dienvx1997bn/doan_20192/Documents/Presentation2.pptx

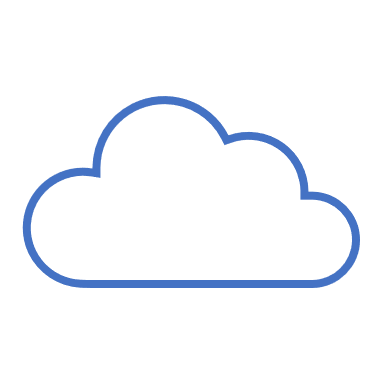
[picture p1: figure]
Cloud

Cảm biến nhiệt độ

Cảm biến
độ ẩm

SQL, Hosting
Web server

GET

POST

View

Định vị GPS

Thiết bị

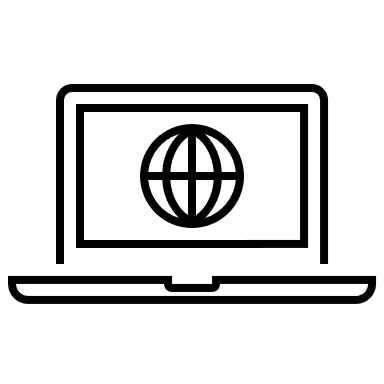
[picture p2: figure]
Internet

Camera
