dienvx1997bn/doan_20192/Documents/Presentation1.png

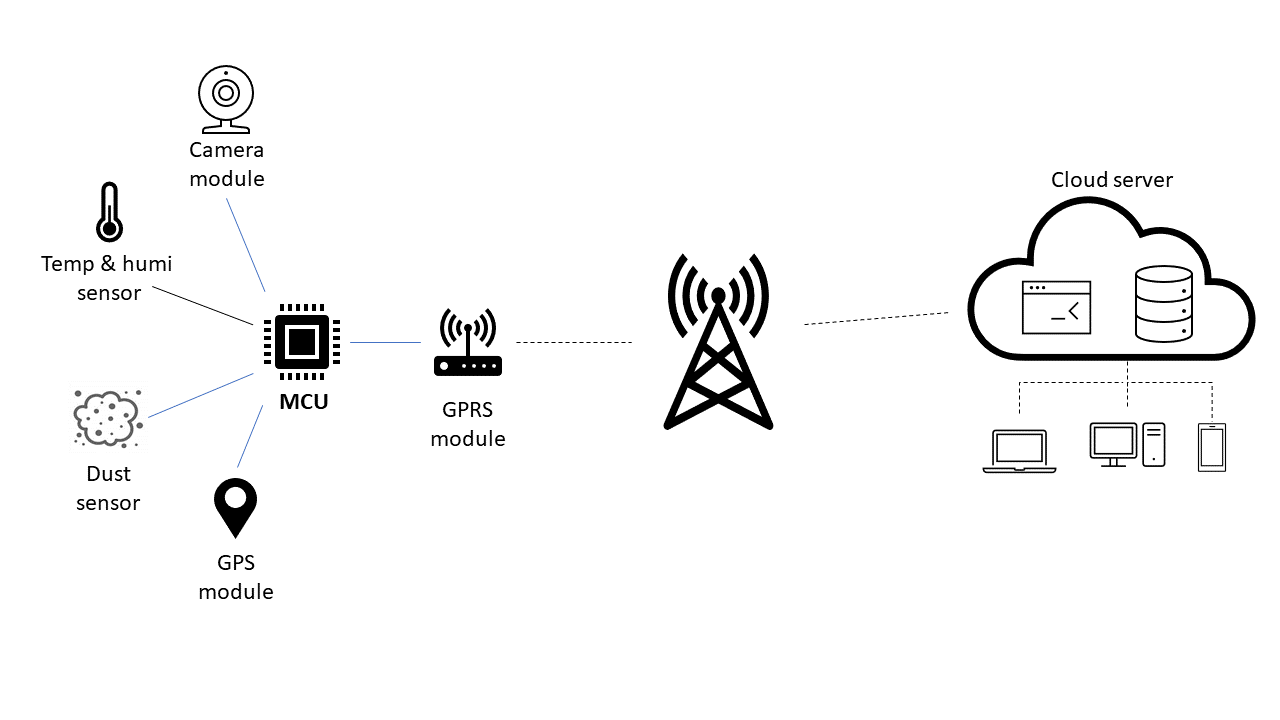
Documents/Presentation1.png
