dienvx1997bn/doan_20192/Documents/Presentation2.png

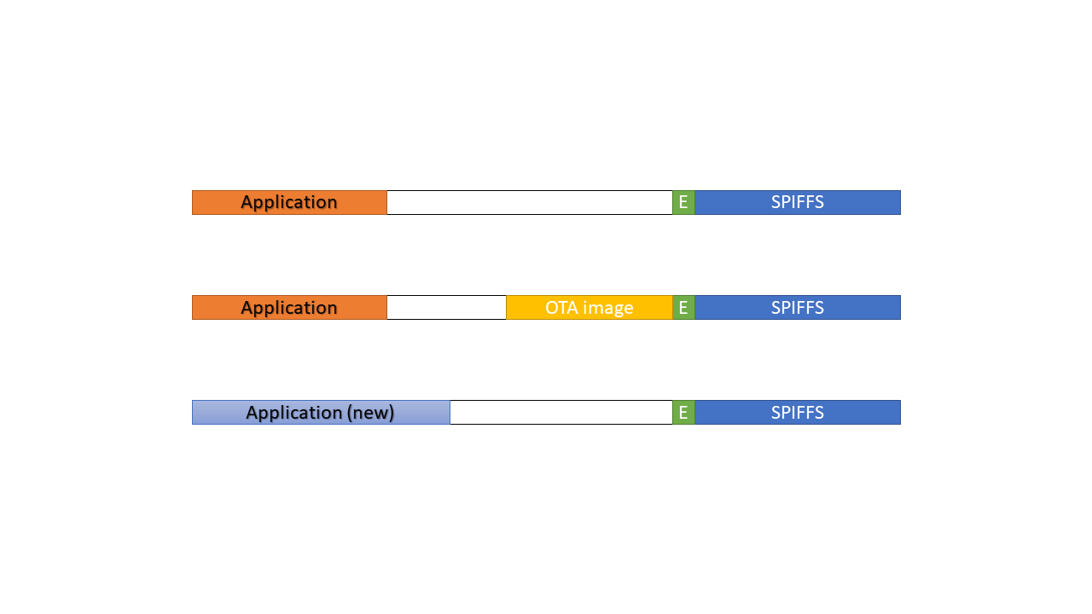
Documents/Presentation2.png
