dienvx1997bn/doan_20192/Documents/Schematic_doan_ver2_2020-06-24_22-46-26.pdf

## TLP521-4

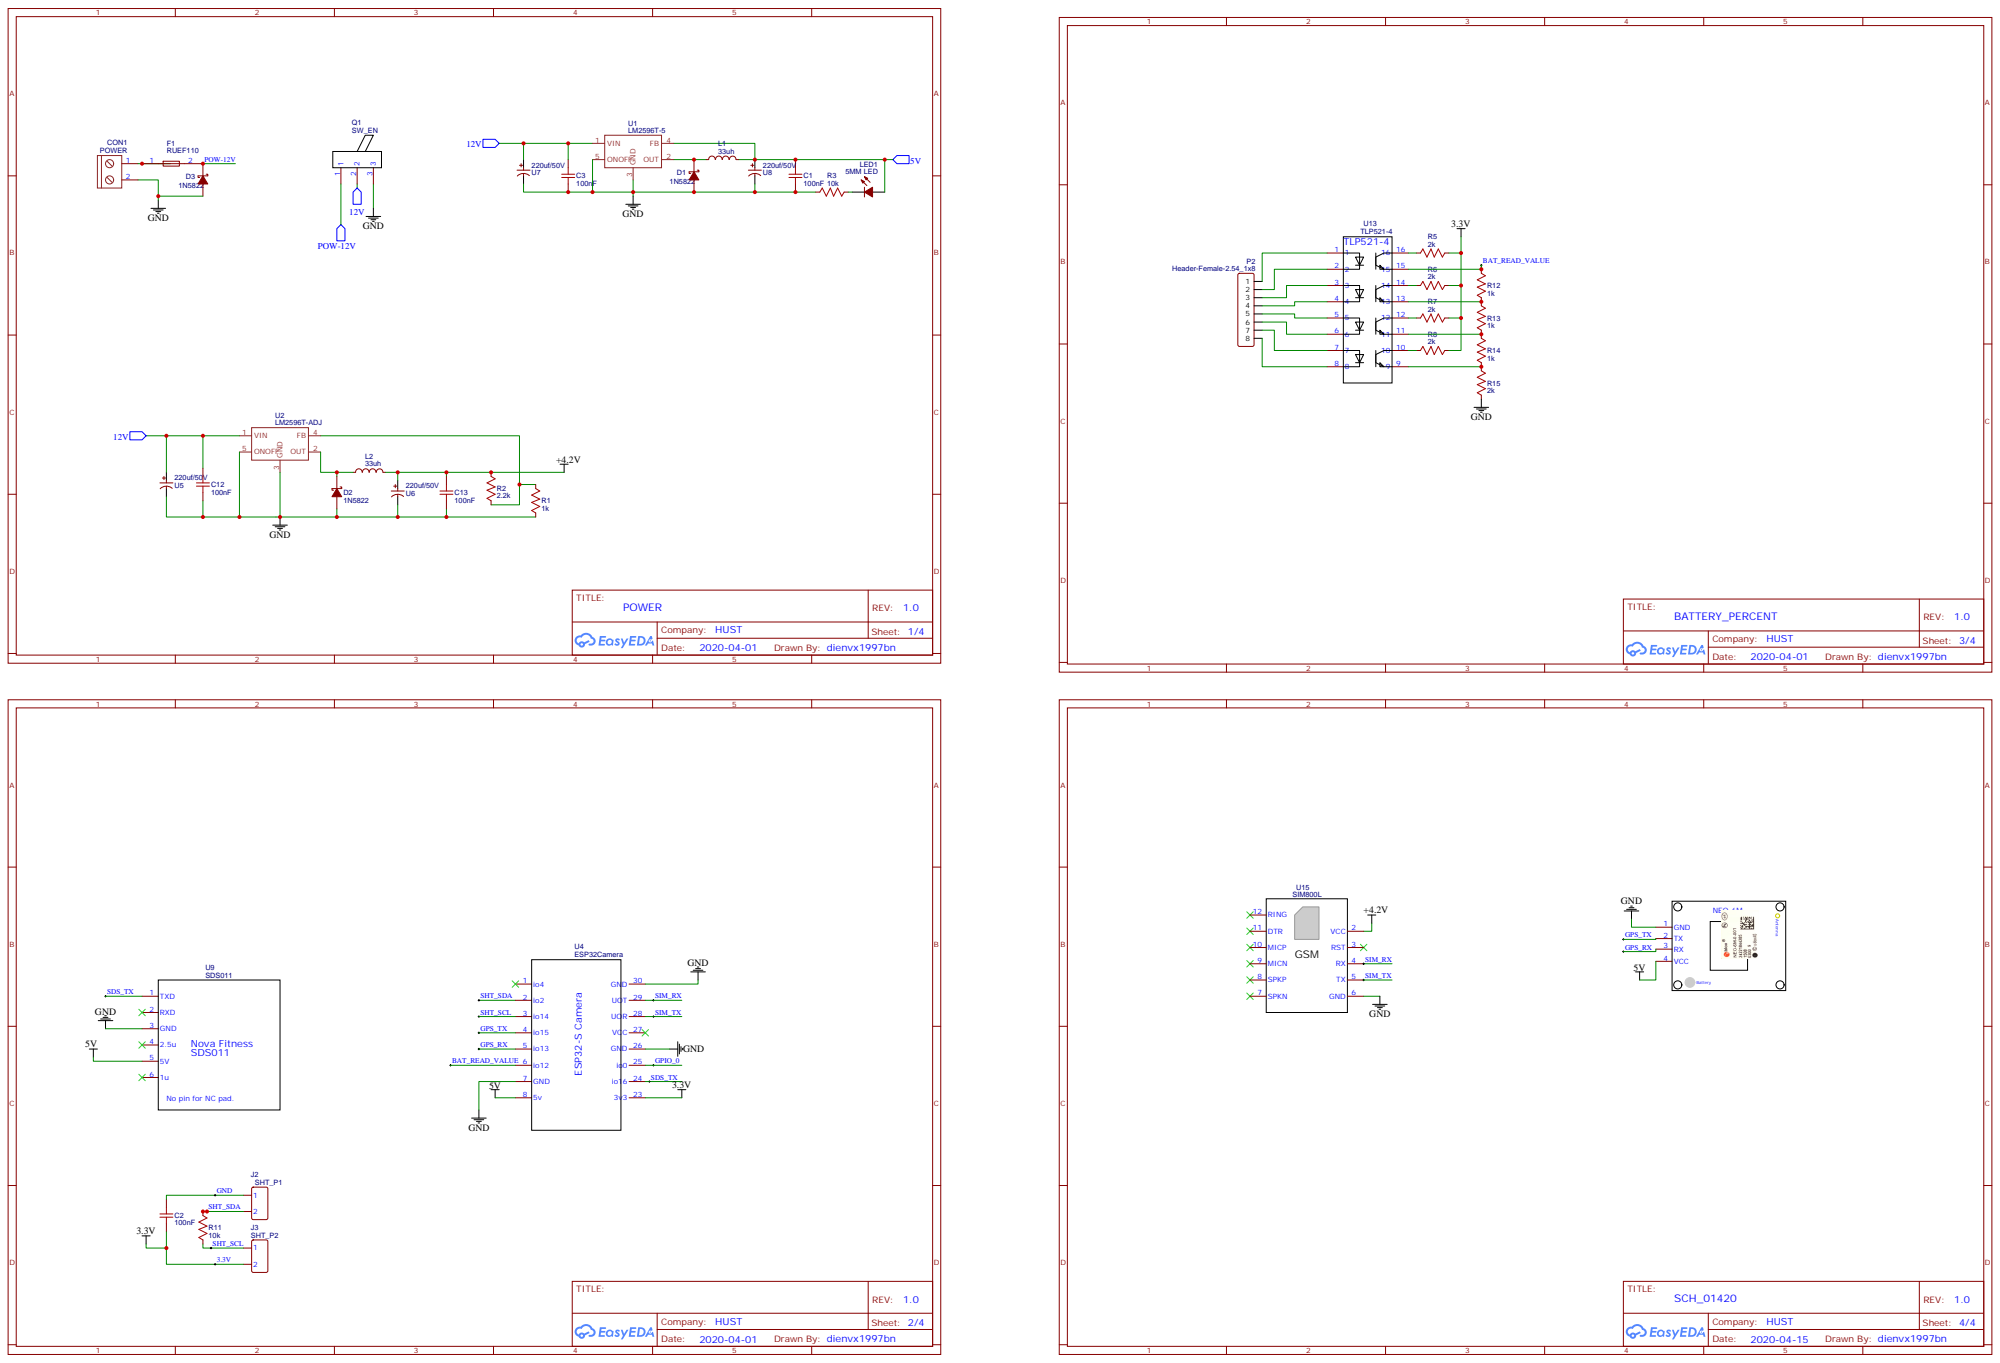
[picture p29: page 1]

No pin for NC pad.
