dienvx1997bn/doan_20192/Documents/Schematic_doan_esp_camera_sim_sht10_Sheet_1_20200405013553.pdf

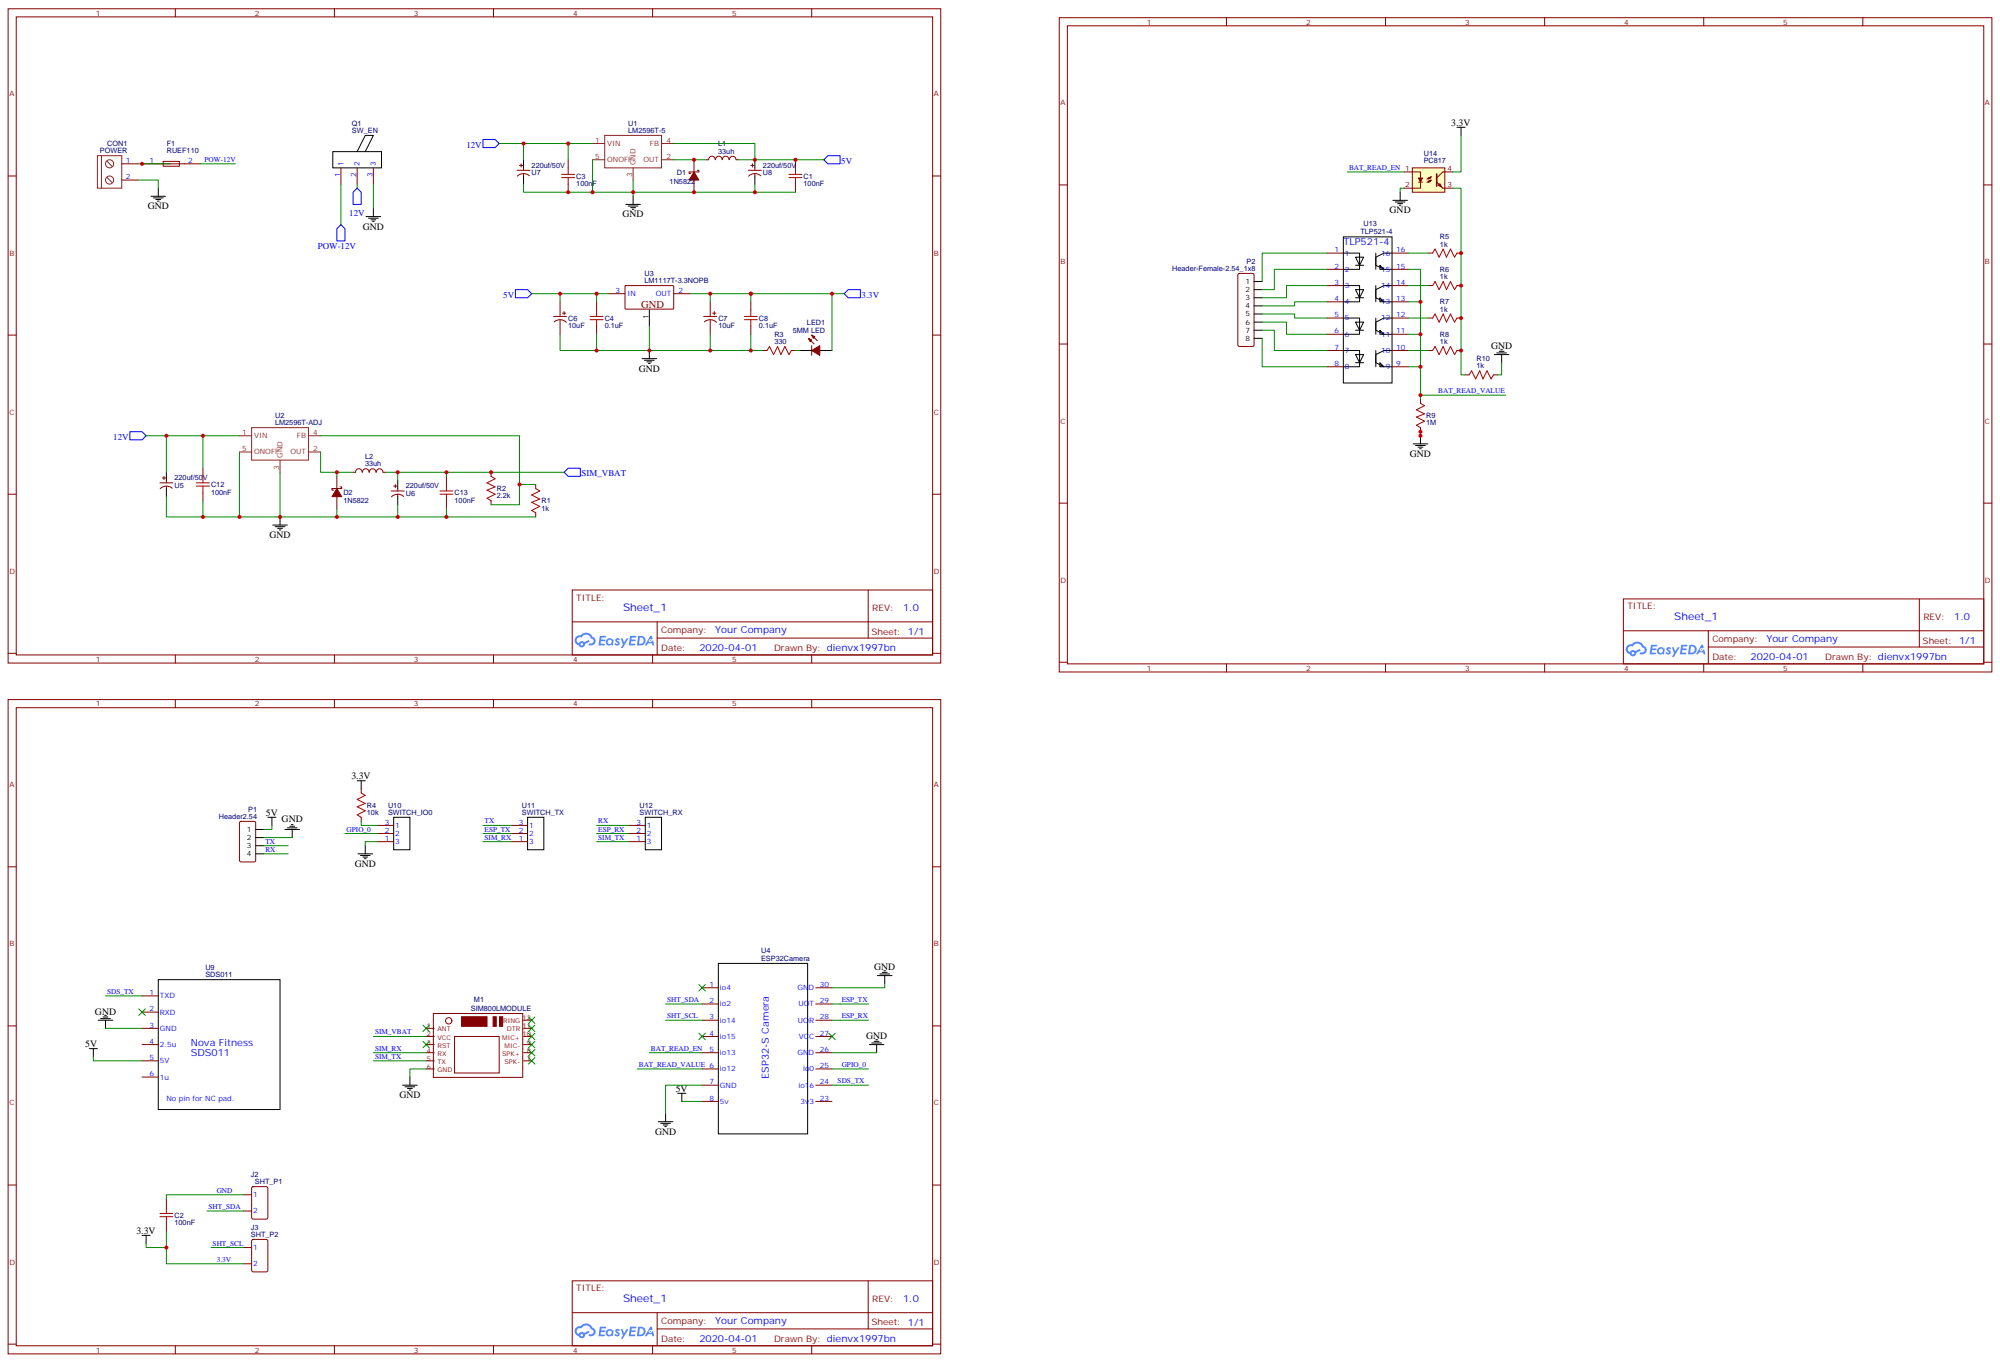
[picture p30: page 1]

No pin for NC pad.
